JuanVH-Coder/Robot-Movil--Sube-pendientes/README.md

Es un proyecto en donde su objetivo es desarrollar e implementar un dispositivo autónomo de transporte para portátiles de
características estándar, capaz de seguir una ruta específica, superando obstáculos
como escaleras. El diseño y construcción del dispositivo incluirá componentes
estructurales propios, permitiendo el uso de partes estandarizadas para mejorar su
eficiencia y seguridad. El proyecto se llevará a cabo durante el presente semestre,
enfocado en garantizar la seguridad de quienes interactúen con el dispositivo,
asegurando un transporte eficiente y confiable del portátil, implementando
tecnologías innovadoras.

El estudio cinemático que se utilizó para el dispositivo fue el de un robot móvil ya
que los movimientos que se realizarán serán similares, en donde se fijó un sistema
de referencia Σ𝑜
(𝑋𝑜, 𝑌𝑜, 𝑍𝑜) de una forma conveniente. Luego se ubicó el sistema
de referencia Σ𝑟(𝑋𝑟
, 𝑌𝑟 ,𝑍𝑟)
Lo cual nos permite hallar los componentes de translación y la orientación de un
robot móvil respecto al sistema de referencia Σ𝑜 , todo esto se muestra en la figura 


Luego como resultado del análisis geométrico la cinemática diferencia con el punto
de control ubicado en el centro del eje que une las ruedas se da por las siguientes
ecuaciones:



Luego para describir la estructura cinemática nos enfocamos en la estructura
B2P2 que es la se utilizara para nuestro dispositivo, y así poder cumplir el objetivo
de subir las escaleras.
n se utilizó el método en robótica de Denavit
Hartenberg en dónde asignamos marcos de referencia como se muestra 





planos: 







video de prueba:

https://github.com/user-attachments/assets/53f4d08a-7c56-4b31-a014-d2bc98b87369

LINK YOUTUBE: https://youtu.be/YQLe4zgnGYg?si=nO8rs0Xk8FrARarz
